chrisitrisi/SelfDrivingRobotExperiments/README.md

# SelfDrivingRobotExperiments

Experimente für einen selbstfahrenden Roboter.

Diese Test-README dient dazu, die GitHub-Verbindung und den ersten Push zu prüfen.
