chrisitrisi/SelfDrivingRobotExperiments/PCB/Liniensensor_Redesign/Lizenzen/QUELLEN.md

# Bibliotheksquellen
Offizielle KiCad-9.0.9-Symbol- und Footprint-Bibliotheken aus dem KiCad Release-PPA.
Originalfamiliennamen sind beibehalten. Footprint-3D-Pfade wurden auf lokale Projektpfade umgestellt.
Das lokale CNY70-Symbol ändert Pin 4 auf passiv; Erläuterung in Hinweise.md.
3D-Modelle aus https://gitlab.com/kicad/libraries/kicad-packages3D (abgerufen 18.10.2026).
Deren eingebettete Urheberhinweise und Lizenztexte bleiben erhalten.
Der Sensor-Sitzabstand von 0,5 mm ist als Modelloffset in der PCB eingestellt.
