chrisitrisi/SelfDrivingRobotExperiments/PCB/Liniensensor_Redesign/Ansichten/Halter.png

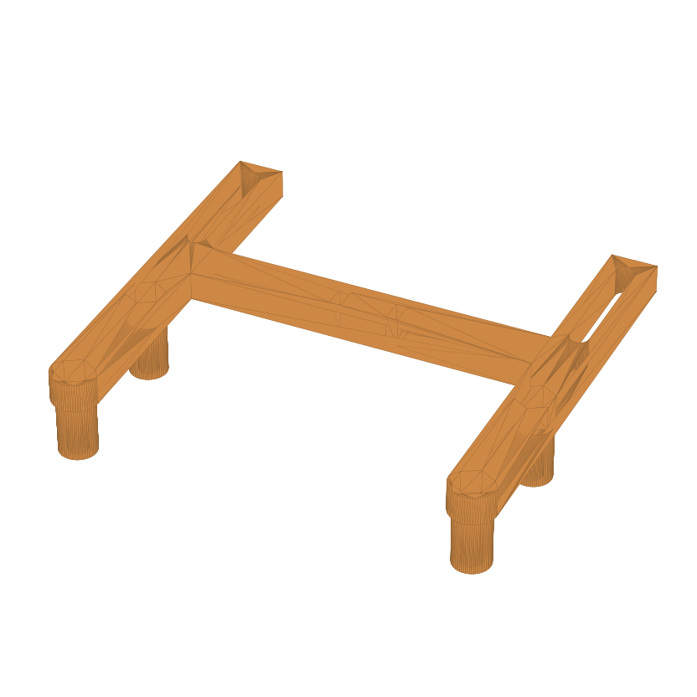
PCB/Liniensensor_Redesign/Ansichten/Halter.png
