chrisitrisi/SelfDrivingRobotExperiments/PCB/Liniensensor_Redesign/Ansichten/Platine_oben.png

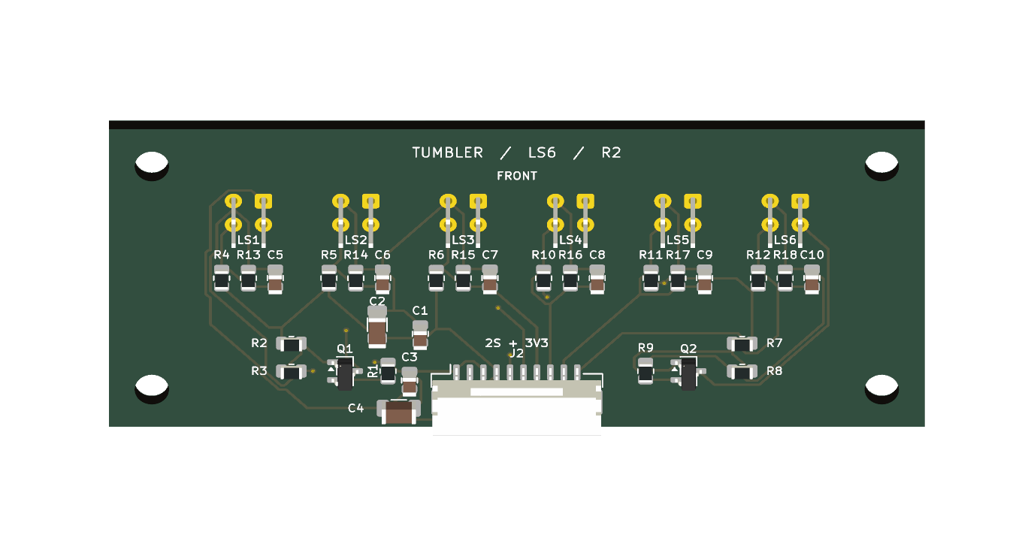
PCB/Liniensensor_Redesign/Ansichten/Platine_oben.png
