chrisitrisi/SelfDrivingRobotExperiments/PCB/Liniensensor_Redesign/Ansichten/Platine_unten.png

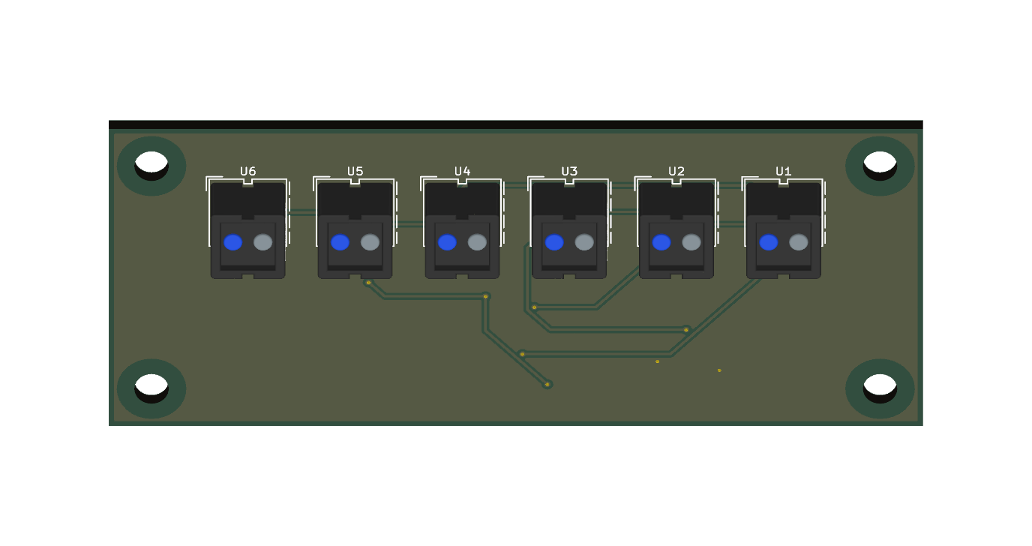
PCB/Liniensensor_Redesign/Ansichten/Platine_unten.png
