chrisitrisi/SelfDrivingRobotExperiments/PCB/Tumbler_Stage1/Ansichten/Tumbler2_Redesign-MCU.png

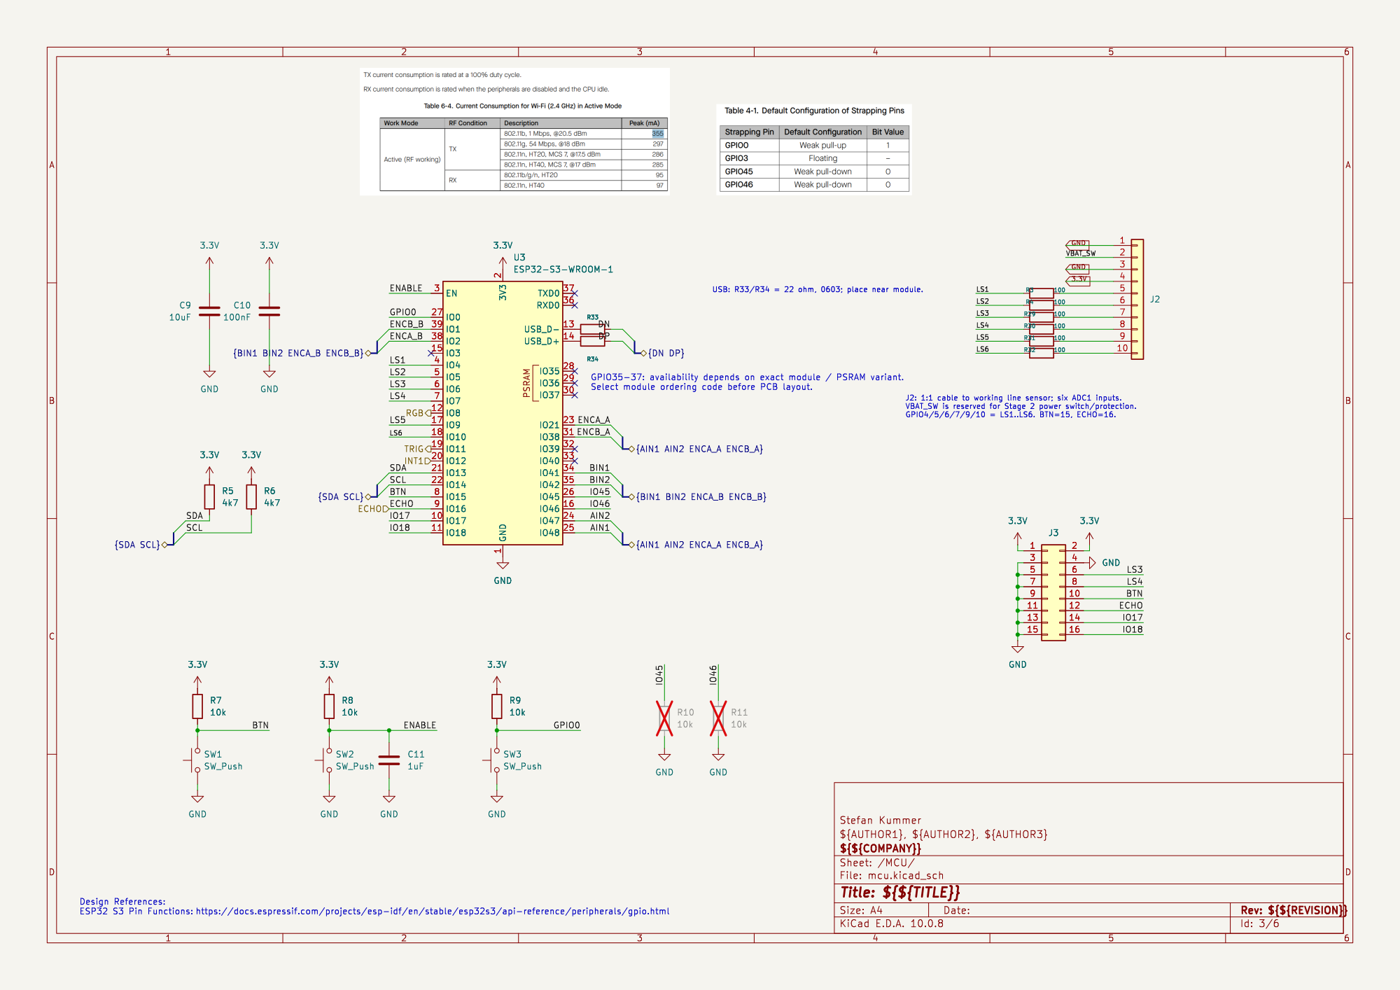
PCB/Tumbler_Stage1/Ansichten/Tumbler2_Redesign-MCU.png
