chrisitrisi/SelfDrivingRobotExperiments/PCB/Tumbler_Stage1/Ansichten/Tumbler2_Redesign-RGB_LEDs.png

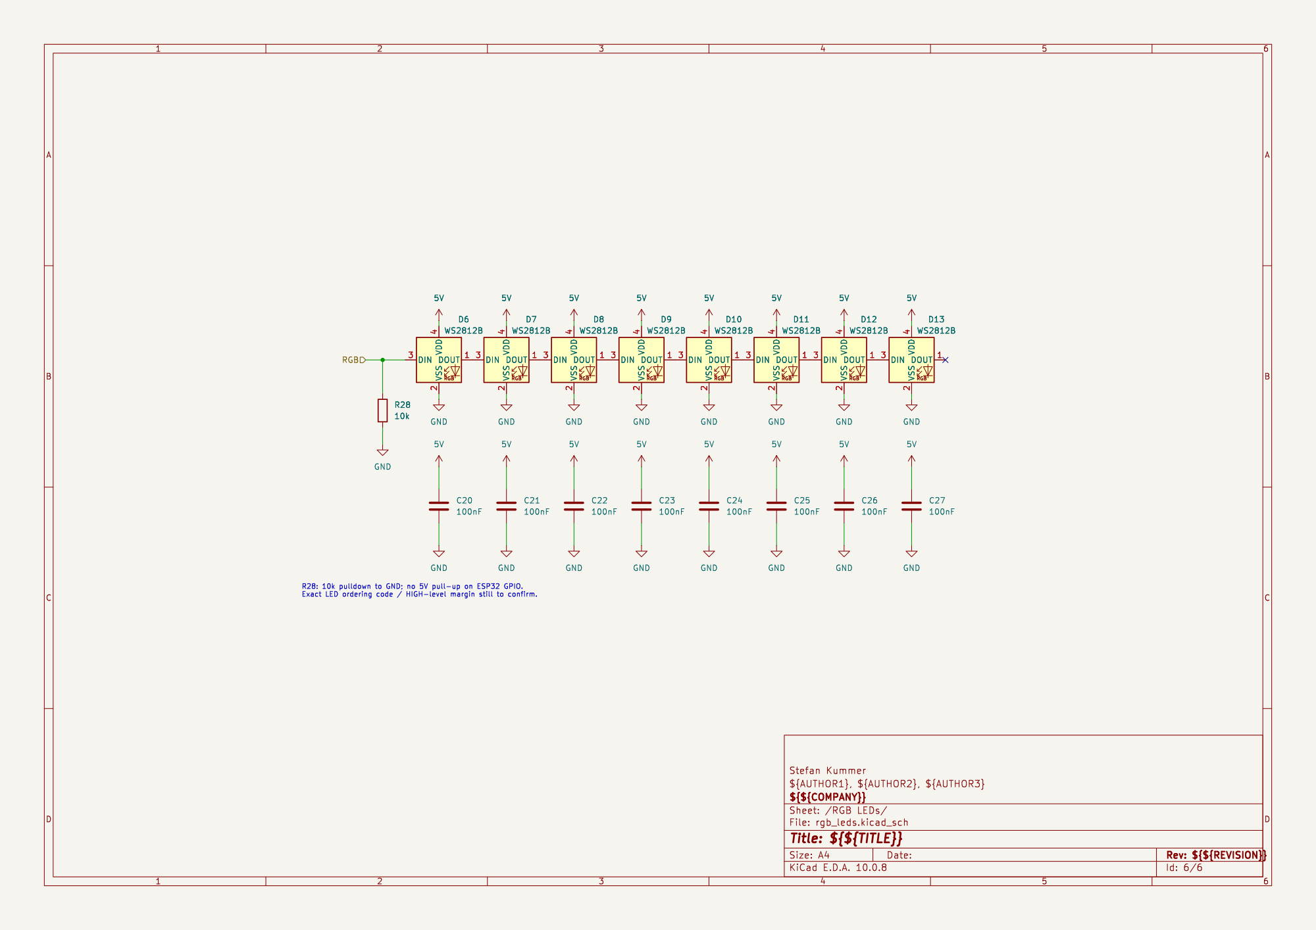
PCB/Tumbler_Stage1/Ansichten/Tumbler2_Redesign-RGB_LEDs.png
