chrisitrisi/SelfDrivingRobotExperiments/PCB/Liniensensor_Redesign/Mechanik/Liniensensor.step

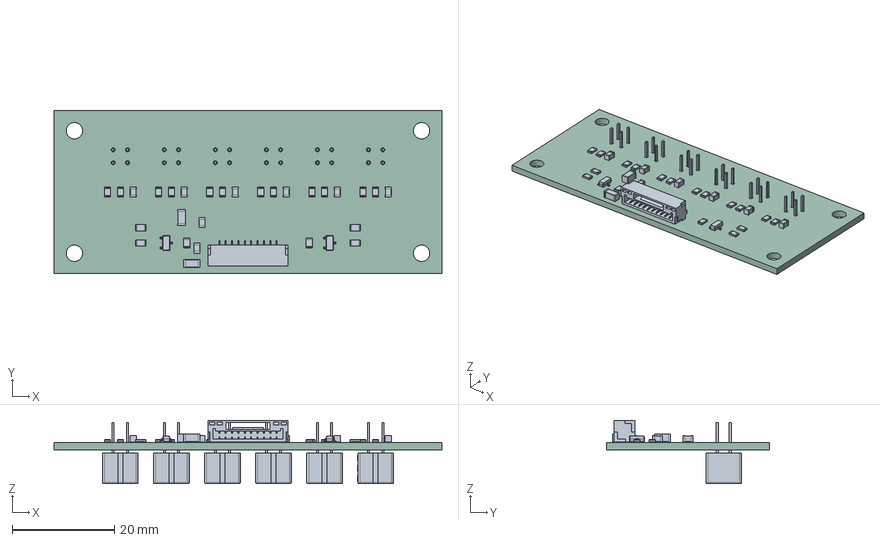
[picture p6: CAD file, 2026-11-04]
PCB/Liniensensor_Redesign/Mechanik/Liniensensor.step
76.0 x 32.0 x 12.4 mm
R_0805_2012Metric x 18
C_1206_3216Metric x 2
C_0805_2012Metric x 8
SOT-23 x 2
JST_GH_SM10B-GHS-TB_1x10-1MP_P1.25mm_Horizontal
Vishay_CNY70 x 6
Liniensensor_PCB
