chrisitrisi/SelfDrivingRobotExperiments/PCB/Liniensensor_Redesign/Mechanik/Distanzscheibe_0p5mm.stl

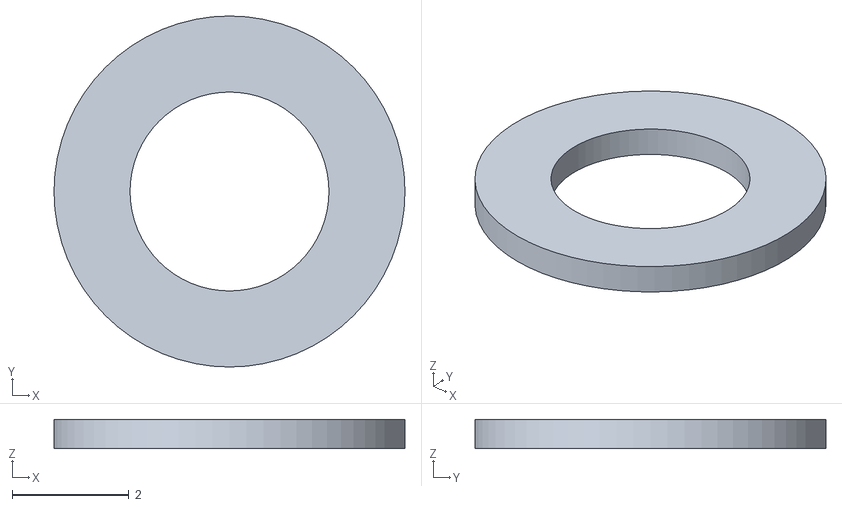
[picture p7: CAD file, 2026-11-04]
PCB/Liniensensor_Redesign/Mechanik/Distanzscheibe_0p5mm.stl
6.00 x 6.00 x 0.5
