chrisitrisi/SelfDrivingRobotExperiments/PCB/Liniensensor_Redesign/Mechanik/Sensorhalter.stl

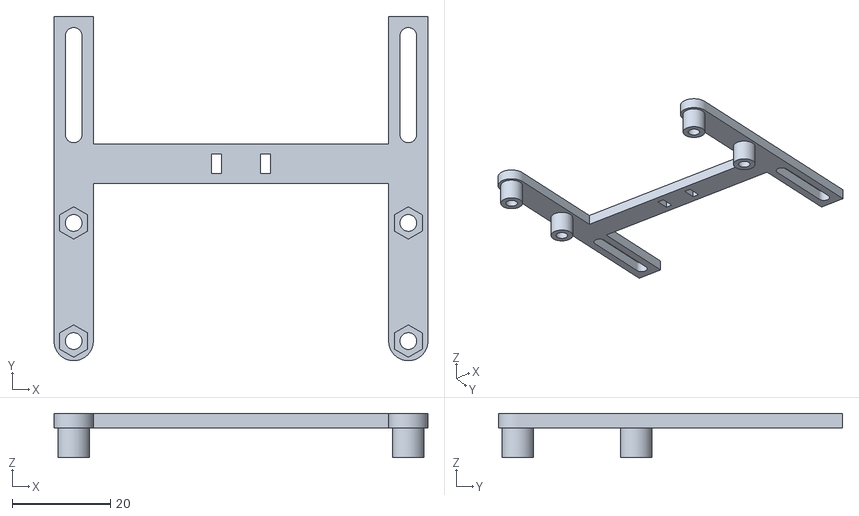
[picture p8: CAD file, 2026-11-04]
PCB/Liniensensor_Redesign/Mechanik/Sensorhalter.stl
76.0 x 70.0 x 9.00
