chrisitrisi/SelfDrivingRobotExperiments/PCB/Liniensensor_Redesign/Mechanik/Distanzscheibe_1mm.stl

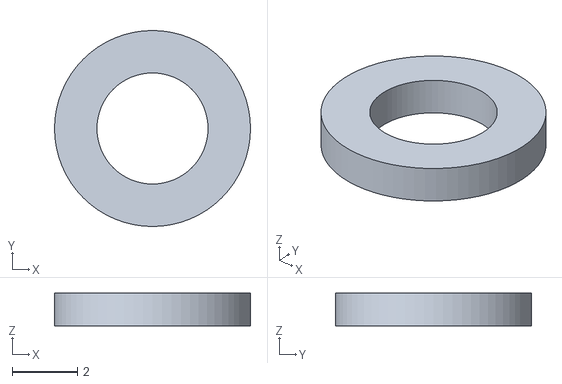
[picture p9: CAD file, 2026-11-04]
PCB/Liniensensor_Redesign/Mechanik/Distanzscheibe_1mm.stl
6.00 x 6.00 x 1.00
