chrisitrisi/SelfDrivingRobotExperiments/PCB/Liniensensor_Redesign/Liniensensor_Redesign/Liniensensor.pdf

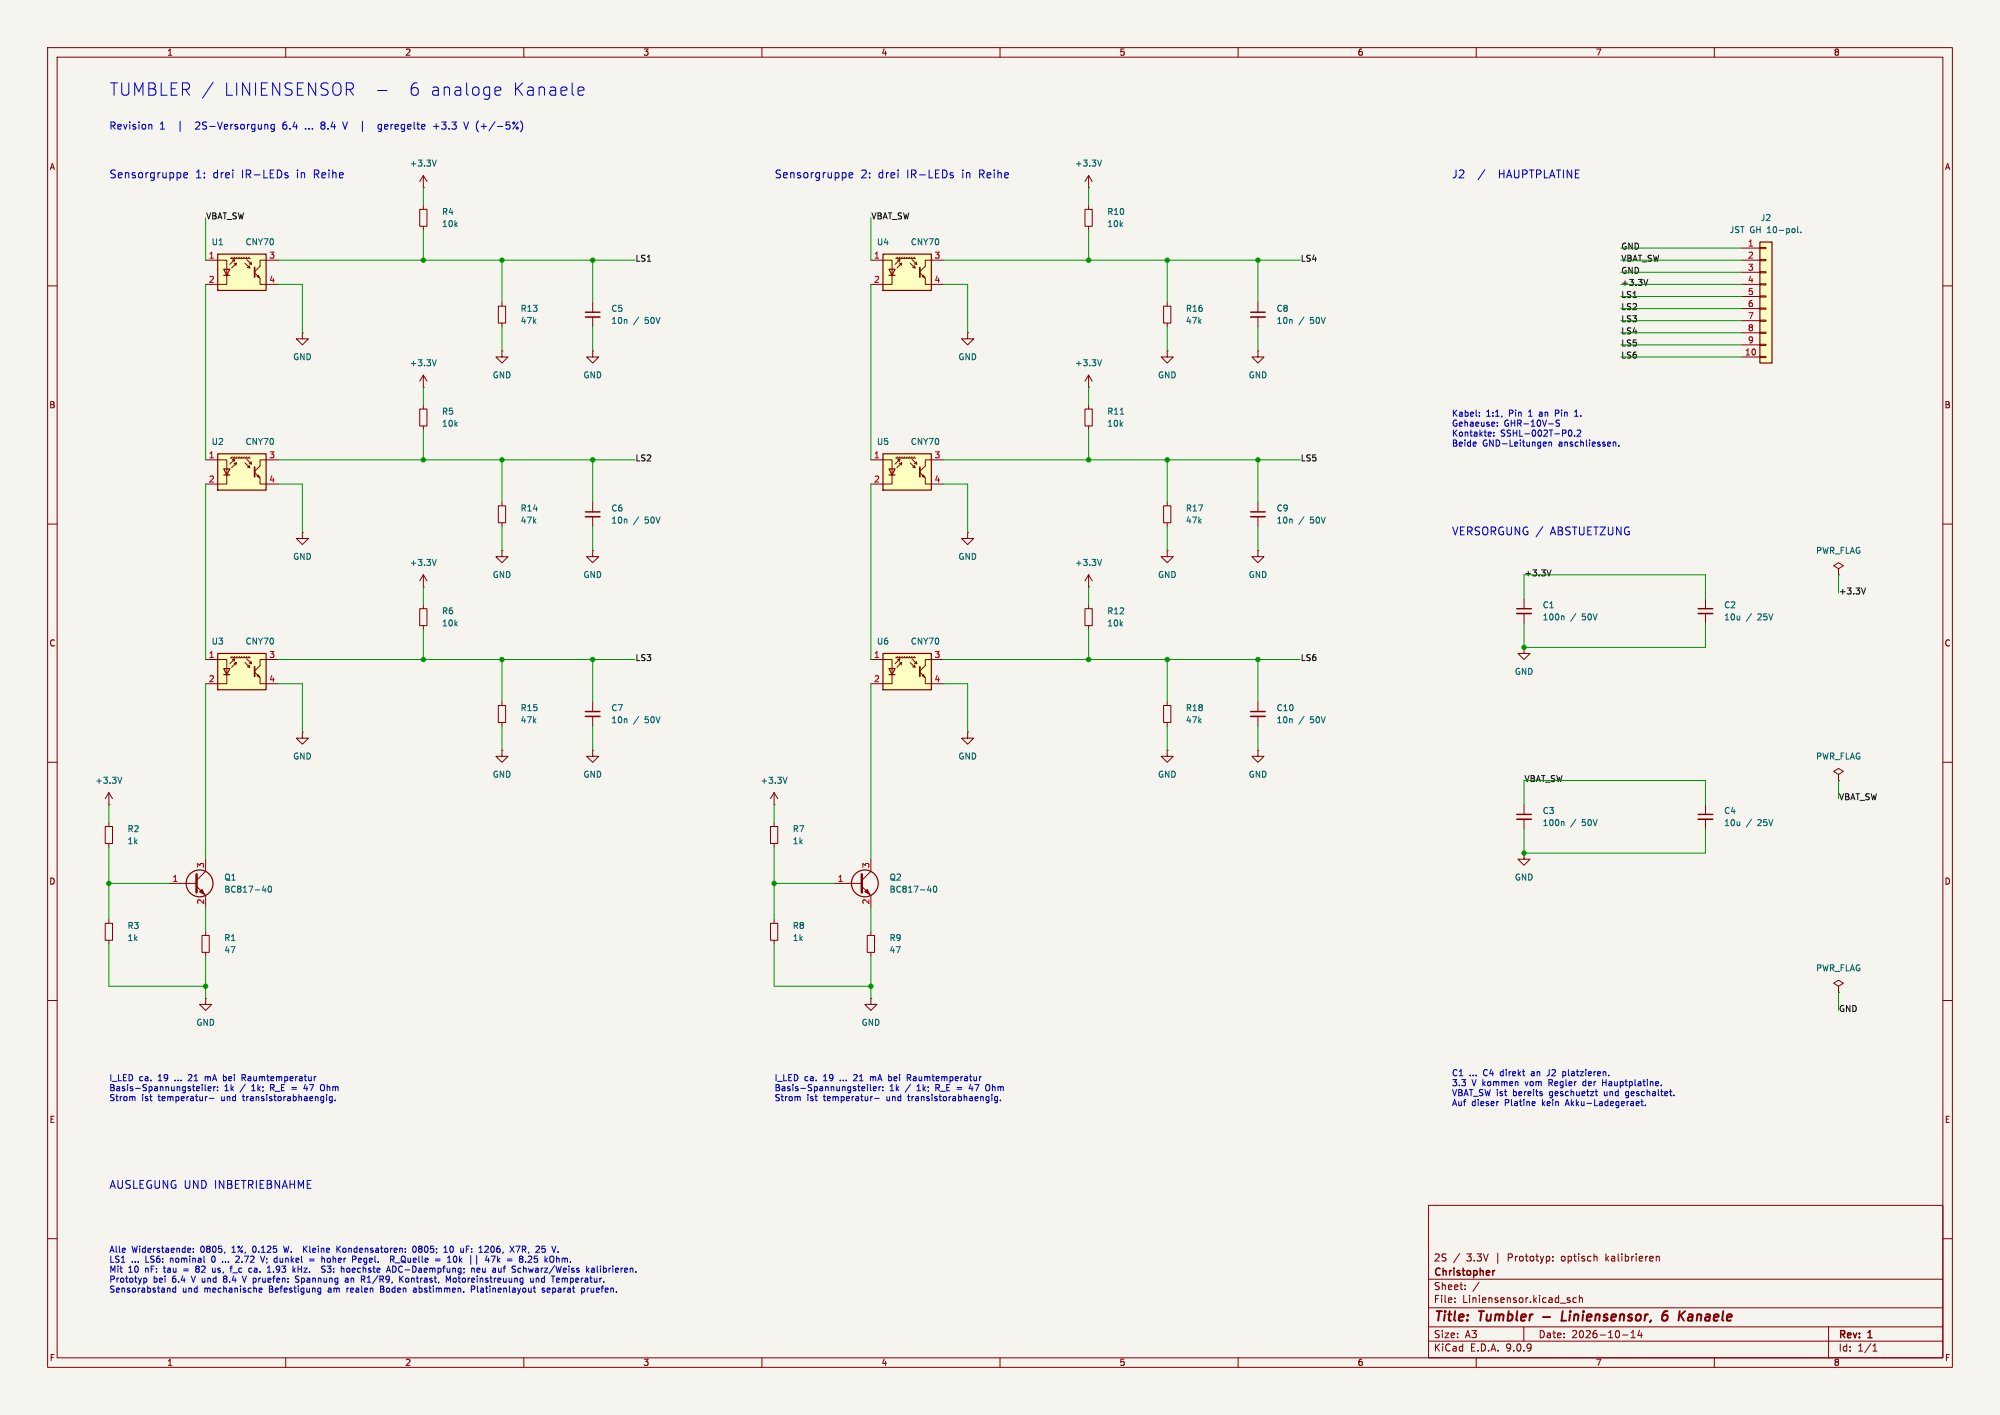
[picture p13: page 1]

Kabel: 1:1, Pin 1 an Pin 1. Gehaeuse: GHR-10V-S

I_LED ca. 19 ... 21 mA bei Raumtemperatur

Id: 1/1 Title: Tumbler - Liniensensor, 6 Kanaele
