chrisitrisi/SelfDrivingRobotExperiments/PCB/Schaltplan_Platine.pdf

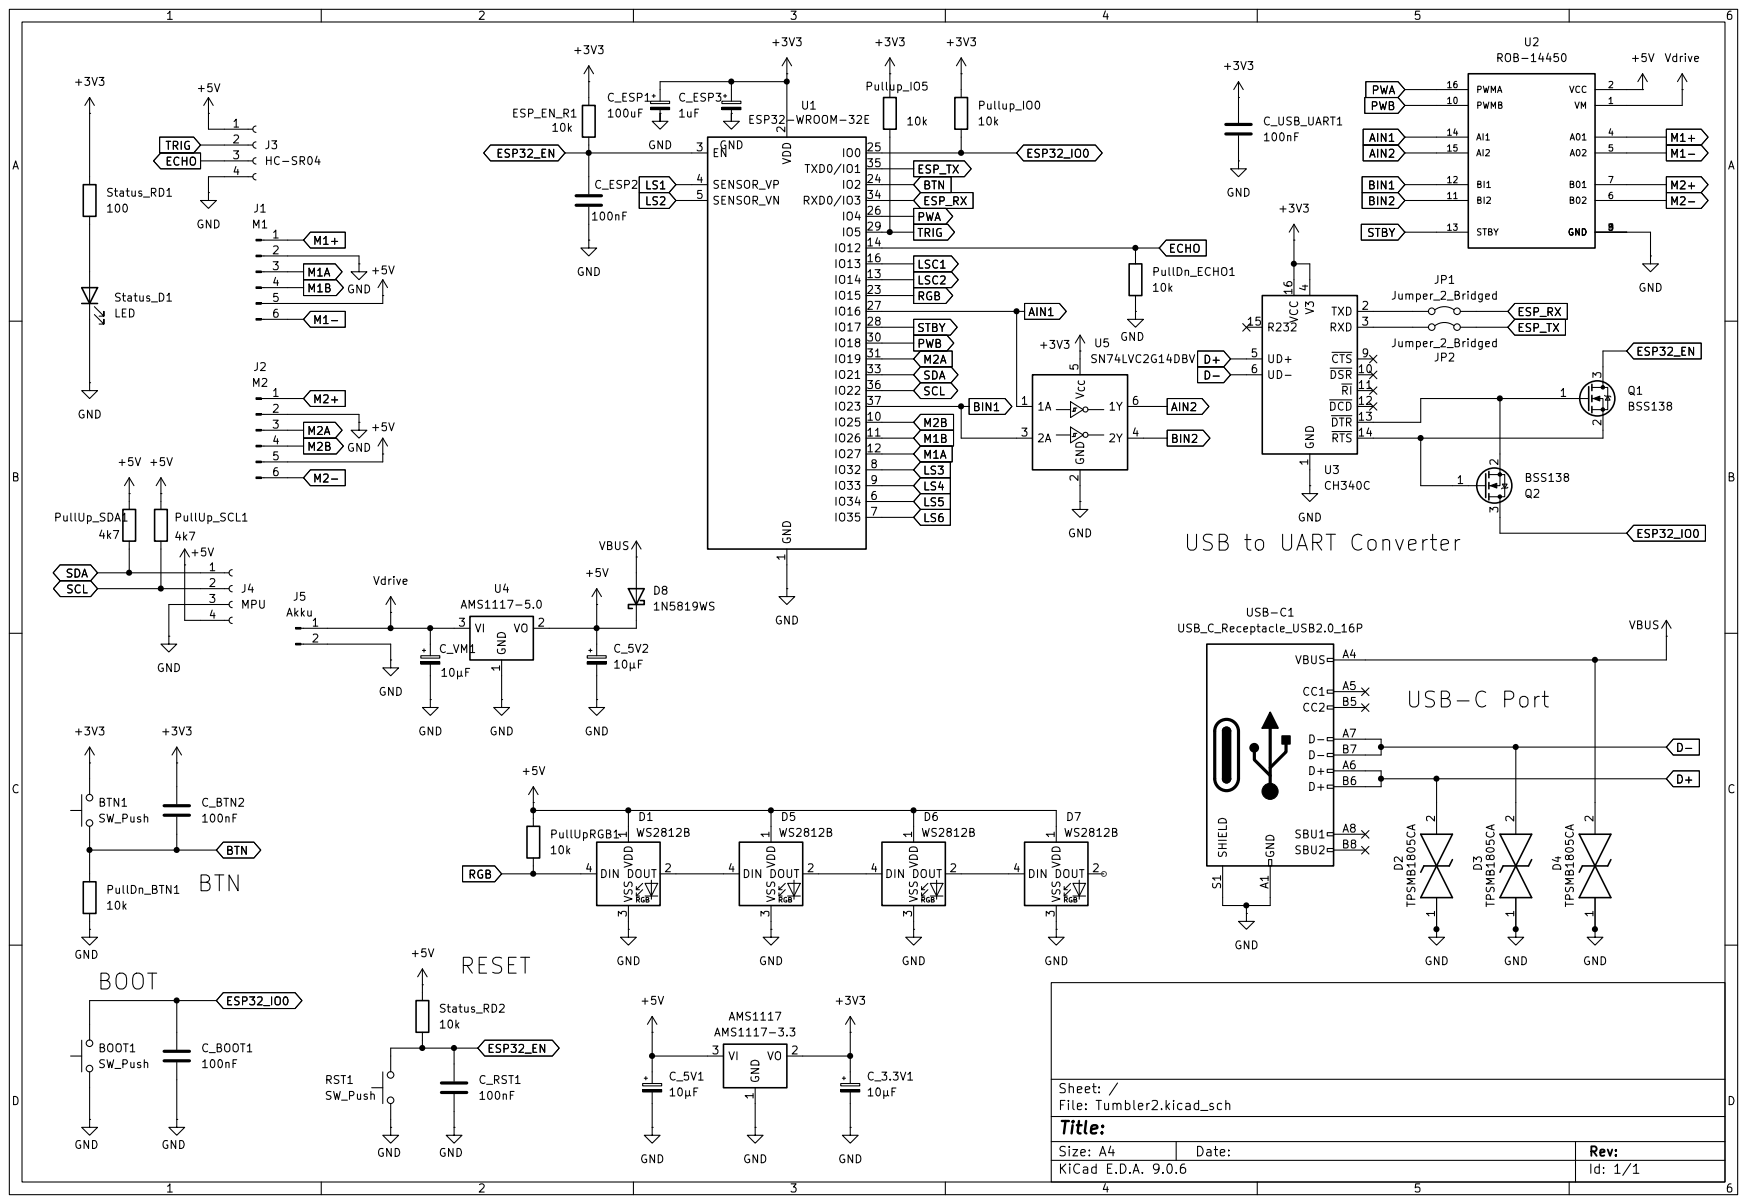
[picture p14: page 1]
