chrisitrisi/SelfDrivingRobotExperiments/PCB/Liniensensor/Liniensensor.kicad_pcb

## KiCad design PCB/Liniensensor/Liniensensor.kicad_pcb (2026-10-14, an earlier design)

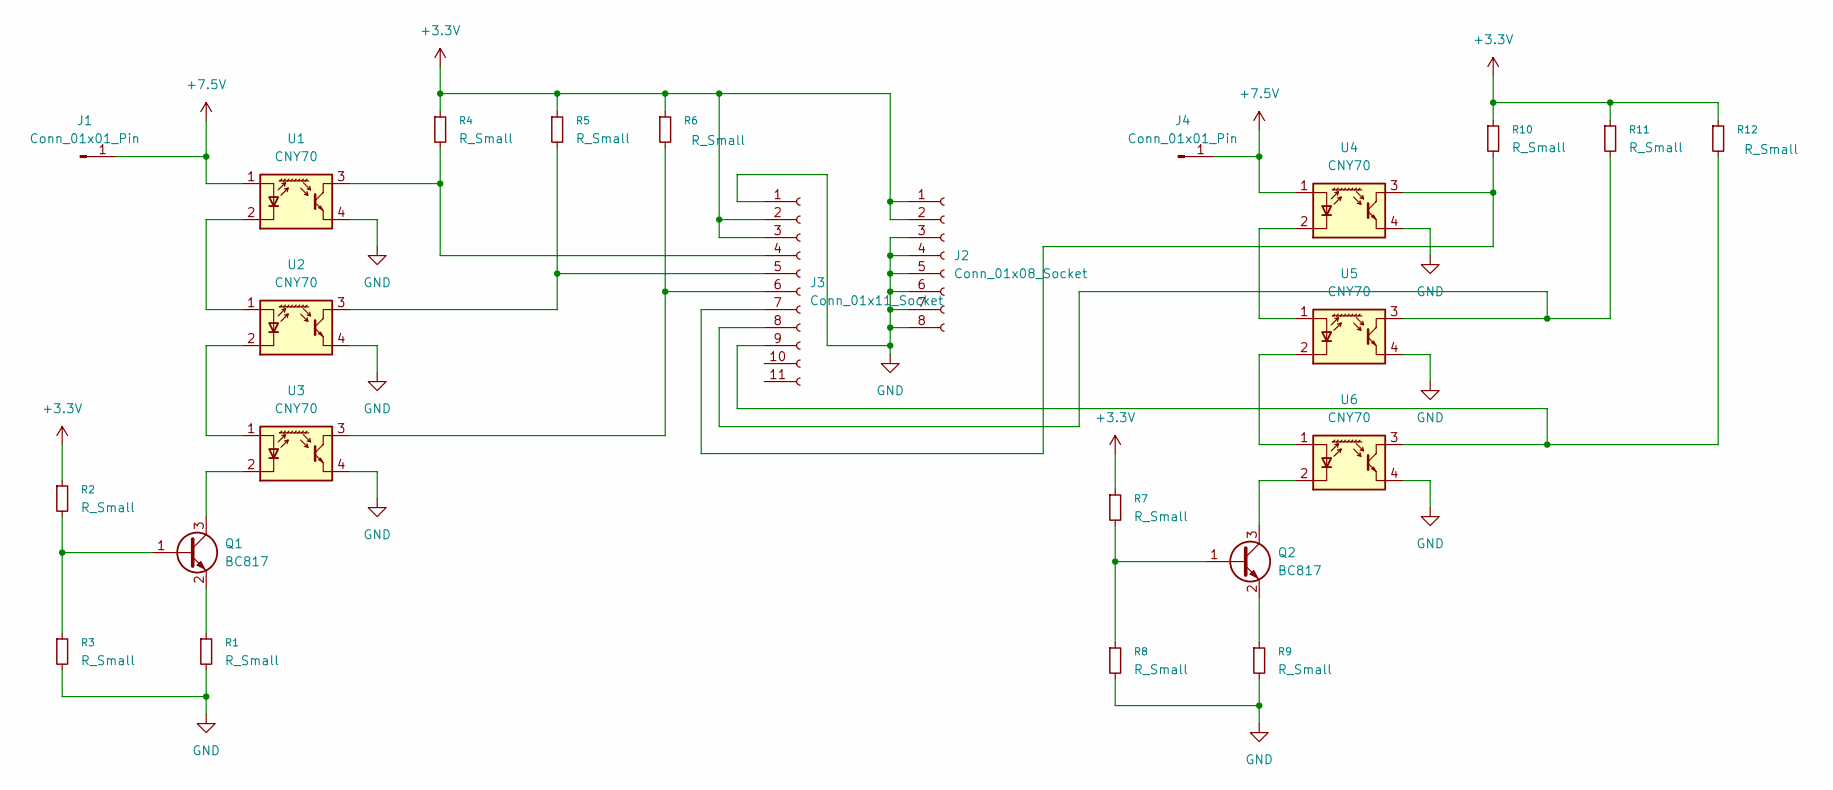
[picture p15: schematic Liniensensor.kicad_sch]

Parts:
J1, J4: Conn_01x01_Pin; SolderWire-0.127sqmm_1x01_D0.48mm_OD1mm
J2: Conn_01x08_Socket; PinSocket_1x08_P2.54mm_Vertical
J3: Conn_01x11_Socket; PinSocket_1x11_P2.54mm_Vertical
Q1, Q2: BC817; SOT-23
R1, R2, R3, R7, R8, R9: R_Small; R_0805_2012Metric_Pad1.20x1.40mm_HandSolder
R4, R5, R6, R10, R11, R12: R_Small; R_Axial_DIN0207_L6.3mm_D2.5mm_P7.62mm_Horizontal
U1, U2, U3, U4, U5, U6: CNY70; Vishay_CNY70

Connections:
+3.3V: J2.1, J2.2, J3.2, J3.3, R2.1, R4.1, R5.1, R6.1, R7.1, R10.1, R11.1, R12.1
+7.5V: J1.1, J4.1, U1.1 (A), U4.1 (A)
GND: J2.3, J2.4, J2.5, J2.6, J2.7, J2.8, J3.1, R1.2, R3.2, R8.2, R9.2, U1.4 (E), U2.4 (E), U3.4 (E), U4.4 (E), U5.4 (E), U6.4 (E)
unnamed: J3.4, R4.2, U1.3 (C)
unnamed: J3.5, R5.2, U2.3 (C)
unnamed: J3.6, R6.2, U3.3 (C)
unnamed: J3.7, R10.2, U4.3 (C)
unnamed: J3.8, R11.2, U5.3 (C)
unnamed: J3.9, R12.2, U6.3 (C)
unnamed: Q1.1 (B), R2.2, R3.1
unnamed: Q1.3 (C), U3.2 (K)
unnamed: Q1.2 (E), R1.1
unnamed: Q2.1 (B), R7.2, R8.1
unnamed: Q2.3 (C), U6.2 (K)
unnamed: Q2.2 (E), R9.1
unnamed: U1.2 (K), U2.1 (A)
unnamed: U2.2 (K), U3.1 (A)
unnamed: U4.2 (K), U5.1 (A)
unnamed: U5.2 (K), U6.1 (A)

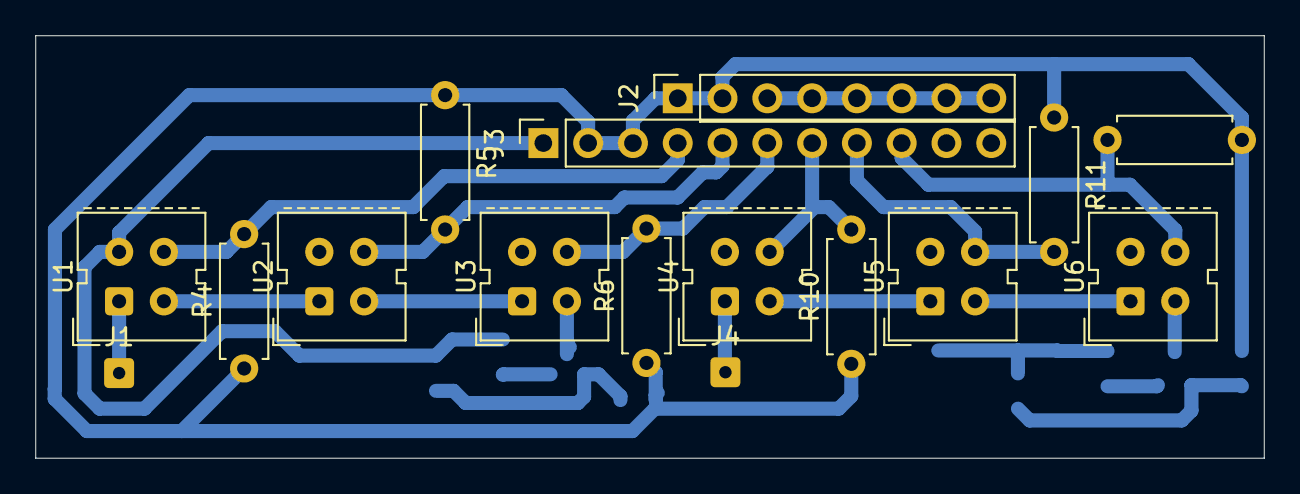
[picture p16: board Liniensensor.kicad_pcb from above]

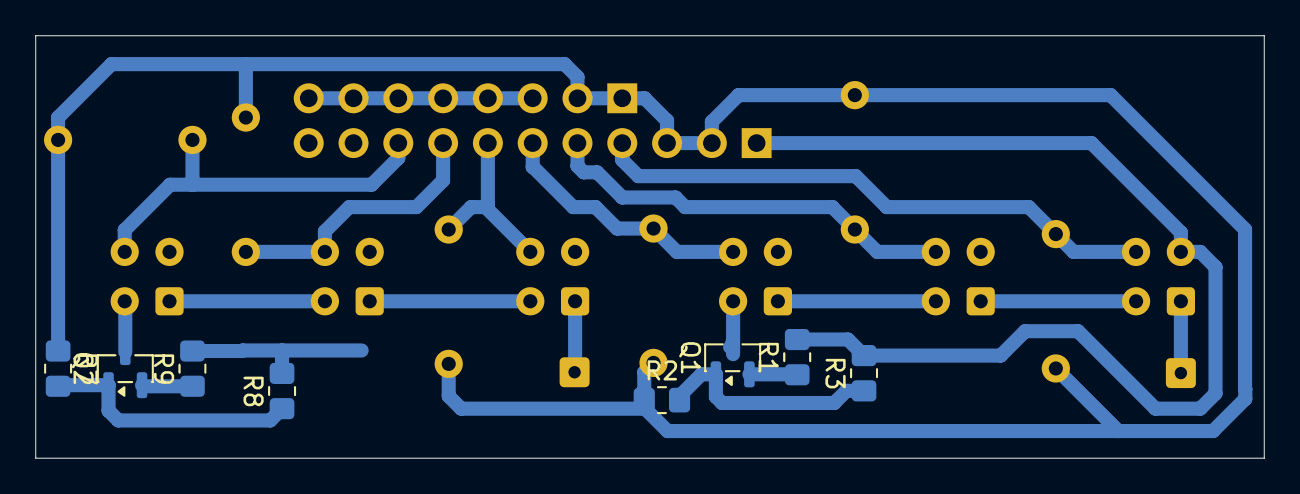
[picture p17: board Liniensensor.kicad_pcb from below]

Board: 2 copper layers, 69.7 x 24.0 mm, 24 parts (8 on the bottom side), 19 nets.
